fberst/RPI4Soar/README.md

# RPI4Soar

RPI4Soar is a gliding computer based on the Raspbery Pi4B running XCsoar (https://www.xcsoar.org/)

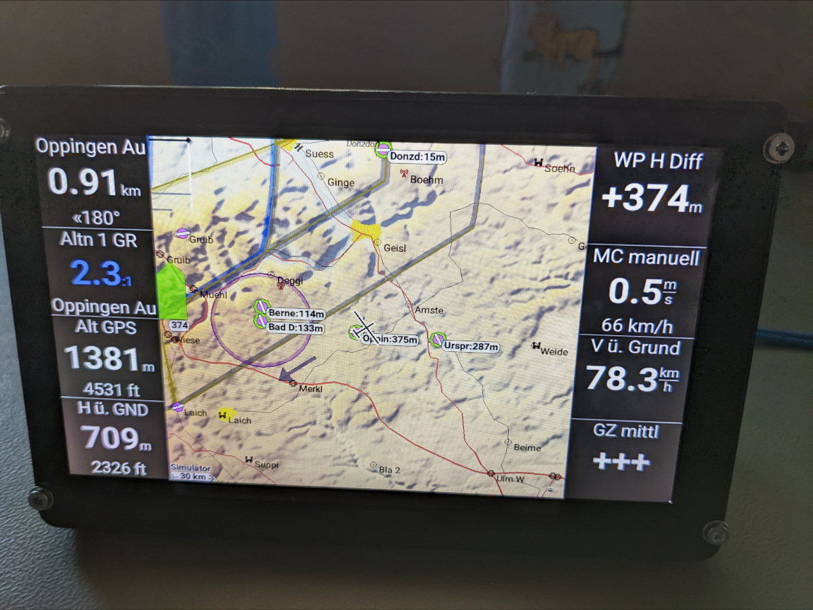
[picture p1: pictures/RPI4Soar.jpg]
RPI4Soar
