fberst/RPI4Soar/pictures/USB_RS232_Adapter_V1_4.jpg

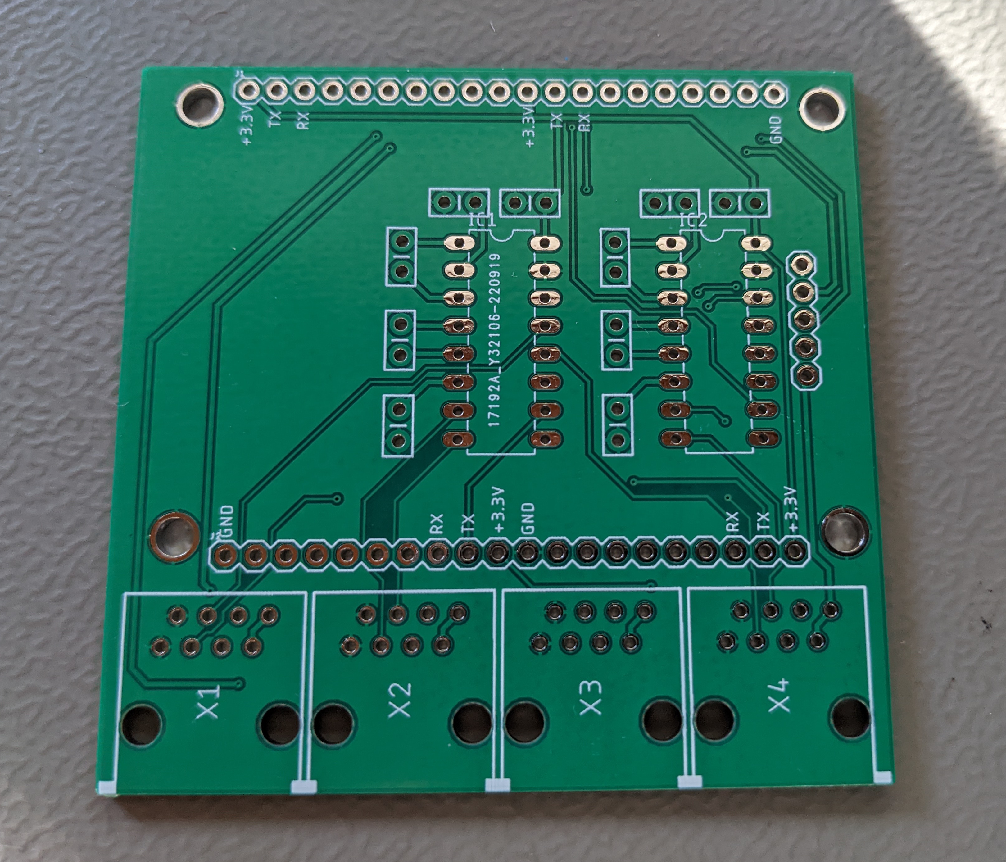
pictures/USB_RS232_Adapter_V1_4.jpg
