fberst/RPI4Soar/documentation/BOM_USB_RS232_V2.ods

Sheet: Parts PCB
# | Part ID | Manufacturer | Part-number | Description | Value | Package | Number of Pins | Source | Price | Quantity | sum
Electronic Parts
1 | IC1, IC2 | Maxim Integrated | MAX 3232 CSE | RS232 level shifter |  | SO-16 | 16 | MAX 3232 CSE | 2,10 € | 2 | 4,20 €
2 | C1, C2, C3, C4, C5, C6, C7, C8, C9, C10 | Samsung Electro-Mechanics | CL21B104KBCNNNC | Capacitor | 100nF | 805 | 2 | 1276-1003-1-ND | 0,07 € | 10 | 0,70 €
3 | X1, X2, X3, X4 | TE Connectivity | 5555162-1 | RJ45-Jacket |  | custom | 8 | 571-5555162-1 | 1,27 € | 4 | 5,08 €
4 | J1, J2 |  | 9900000736774 | socket strip |  | 1x20 2,54mm | 20 | BL 1X20G7 2,54 | 1,06 € | 2 | 2,12 €
5 | FT4232 USB-TTL Converter | Alixpress |  |  |  |  |  |  | 10,69 € | 1 | 10,69 € | https://de.aliexpress.com/item/1005001928940997.html?curPageLogUid=mFcxdsNxnEyo
PCB
6 | USB_RS232_Adaper_V2 | Smart-Prototyping |  |  |  |  |  |  | 2,00 € | 1 | 2,00 €
Mechanical Parts
7 | USB_RS232_Adapter_V1-housing.stl | hubs.com |  |  |  |  |  |  | 11,67 € | 1 | 11,67 €
8 | USB_RS232_Adapter_V1-cap.stl | hubs.com |  |  |  |  |  |  | 9,23 € | 1 | 9,23 €
9 | hexagonal spacer bolt M3, Inner/inner, 8mm length | buerklin | 20080312 |  |  |  |  | 20080312 | 0,19 € | 4 | 0,74 €
10 | hexagonal spacer bolt M3, Inner/outer, 10mm bolt length, 16mm overall length | buerklin | 971100321 |  |  |  |  | 971100321 | 0,32 € | 4 | 1,28 €
11 | Torx screw M3x6mm, countersunk head | screwsandmore | 965236TX_558 |  |  |  |  | 965236TX_558 | 3,99 | 1 | 3,99 € | (4 necessary, but sold in 50-pack)
12 | Torx screw M3x14mm, countersunk head | screwsandmore | 9652314TX_4170 |  |  |  |  | 9652314TX_4170 | 4,69 | 1 | 4,69 € | (4 necessary, but sold in 50-pack)
 |  |  |  |  |  |  |  |  |  |  | 56,39 €

Sheet: Mechanical Parts
# | Description | Part number | Source | Price | Quantity | Sum
1 | Countersunk screw M3x14 | 9652314TX_4170 | screwsandmore | 0,10 € | 4 | 0,40 €
2 | Countersunk screw M3x6 | 965236TX_558 | screwsandmore | 0,08 € | 4 | 0,32 €
3 | standoff M3x10 inner / outer | H1202 ST ZN M3X10 | buerklin | 0,30 € | 4 | 1,20 €
4 | standoff M3x8 inner / outer | 18H2456 | buerklin | 0,20 € | 4 | 0,80 €
5 | housing |  | 3d printed |  | 1
6 | cap |  | 3d printed |  | 1
7 | FT4232 |  | aliexpress.com | 12,54 € | 1 | 12,54 €
 |  |  |  |  |  | 15,26 €
 | FT4232 link:
 | https://www.aliexpress.com/item/1005001928940997.html
