fberst/RPI4Soar/documentation/BOM_RPI4Soar_V2.ods

Sheet: mechanical
# | Description | Part number | Source | Price | Quantity | Sum
1 | mounting block | Typ 05.60.425 | buerklin | 0.89 € | 8 | 7.12 €
2 | M2,5x6 lens hat screw |  | screwsandmore |  | 8
3 | M2,5x10 lens hat screw |  | screwsandmore |  | 4
4 | M2,5x8 countersunk screw |  | screwsandmore |  | 8
5 | M1,6x6 countersunk screw |  | screwsandmore |  | 6
6 | M1,6 nut |  | screwsandmore |  | 6
7 | standoff bolt M2,5x10 inner/outer thread |  | buerklin |  | 4
8 | M2,5 nut |  | screwsandmore |  | 4
9 | M3x30 screw |  | screwsandmore |  | 4
10 | M3 nut |  | screwsandmore |  | 4
11 | RPI4Soar_V2-frame |  | 3d-printed |  | 1
12 | RPI4Soar_V2-housing |  | 3d-printed |  | 1
13 | RPI4Soar_V2-backplate |  | 3d-printed or lasercut |  | 1
14 | RPI4Soar_V2-spacer |  | 3d-printed |  | 4

Sheet: electrical
# | Description | Part number | Source | Price | Quantity | Sum
1 | Raspberry Pi4B |  |  |  | 1
2 | micro-sd card |  |  |  | 1
3 | HA-070XIEB0GH6-A-DGW Display |  | texim | 86.16 € | 1 | 86.16 € | https://www.texim-europe.com/product/HA-070XIEB0GH6-A-DGW
4 | Micro-hdmi type d male connector 90 degree Angled to flat ribbon cable |  | amazon | 7.99 € | 1 | 7.99 € | https://www.amazon.de/gp/product/B01M0AO3J3/ref=ppx_yo_dt_b_asin_title_o00_s00?ie=UTF8&psc=1
5 | hdmi connector 90 degree angled to ribbon cable |  | amazon | 9.35 € | 1 | 9.35 € | https://www.amazon.de/gp/product/B07R6CWPH1/ref=ppx_yo_dt_b_asin_title_o00_s00?ie=UTF8&psc=1
6 | ribbon cable |  | amazon |  | 1
7 | mpx power connector |  | hoelleinshop | 1.50 € | 1 | 1.50 € | https://www.hoelleinshop.com/mpx-hochstromstecker-M6-50.htm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
8 | mpx power connector mounting frame |  | hoelleinshop | 0.90 € | 1 | 0.90 € | https://www.hoelleinshop.com/Alles-fuer-den-Elektroflug/Elektroflug-Zubehoer/Steckersysteme/sonstige-Stecker/Einbaurahmen-lang-zu-MPX-Hochstromstecker-Buchse.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
9 | power supply pcb (see eagle files) |  |  |  | 1
10

Sheet: pcb_parts
# | Part ID | Manufacturer | Part-number | Description | Value | Package | Number of Pins | Source | Price | Quantity
1 | J1 | W+P | W+P 153PF-040-2 | Raspberry Pi4B pin-socket | --- | THT 2,54mm 2x20 | 40 | W+P 153PF-040-2 | 6.40 € | 1
2 | U$1 | Traco Power | THN 15-2411WI-A1 | 5V voltage regulator | 5V | custom | 6 | 495-THN15-2411WI-A1 | 40.06 € | 1
3 | U$2 | Traco Power | THN 15-2412WI | 12V voltage regulator | 12V | custom | 6 | 495-THN-15-2412WI | 38.10 € | 1
4 | D1 | LSCE | 1N 4004 | diode | --- | DO41-10 | 2 | 1N 4004 | 0.05 € | 1
5 | F1 | Littelfuse | LITT RUEF185 | fuse | --- | custom | 2 | LITT RUEF185 | 0.37 € | 1
optional features, not used at the moment, untested
the connectors can be left out and wires soldered direct to the pads
6 | J2 | Garry | MPE 087-2-006 | fan connector | --- | 2x3, 2,54mm | 6 | MPE 087-2-006 | 0.16 € | 1
7 | J3 | Garry | MPE 087-1-004 | RS232 connector | --- | 1x4, 2,54mm | 4 | MPE 087-1-004 | 0.11 € | 1
8 | J4 | JST | JST XH3P ST90 | backlight dimming connector | --- | 1x3, 2,54mm | 3 | JST XH3P ST90 | 0.24 € | 1
9 | J6 | JST | JST XH2P ST90 | backlight power connector |  | 1x2, 2,54mm | 2 | JST XH2P ST90 | 0.20 € | 1
10 | J7 | JST | JST XH2P ST90 | power connector |  | 1x2, 2,54mm | 2 | JST XH2P ST90 | 0.20 € | 1
11 | IC1 | Maxim | MAX 3232 CPE | RS232 level shifter | MAX 3232 CPE | PDIP-16 | 16 | MAX 3232 CPE | 8.23 € | 1
12 | C1, C2, C3, C4, C5 | Vishay / BC Components | K104K15X7RF5UL2 | capacitor | 100nF | THT 2,54mm | 2 | 594-K104K15X7RF5UL2 | 0.23 € | 5
