fberst/RPI4Soar/CAD/RPI4Soar_V2.FCStd

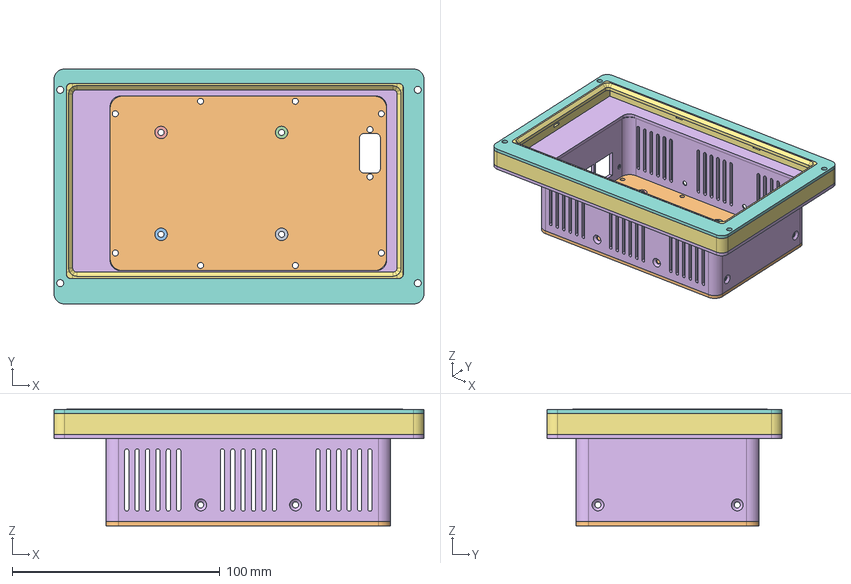
[picture p6: CAD file, 2023-02-26]
CAD/RPI4Soar_V2.FCStd
178.0 x 113.0 x 56.1 mm
Spacer
Backplate
Spacer1
Spacer2
Spacer3
housing
frame
template
