fberst/RPI4Soar/CAD/RPI4Soar_V2-template.stl

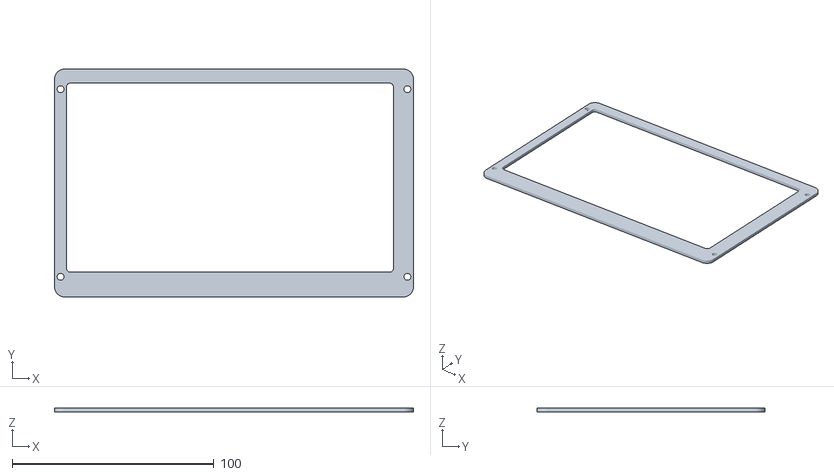
[picture p7: CAD file, 2023-02-26]
CAD/RPI4Soar_V2-template.stl
178.0 x 113.0 x 2.00
