fberst/RPI4Soar/CAD/RPI4Soar_V2-housing.stl

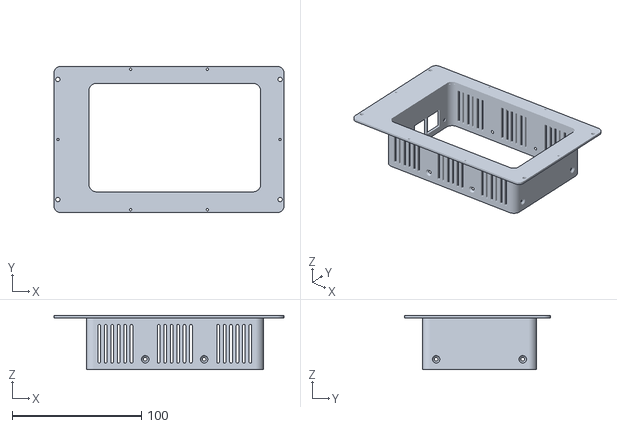
[picture p8: CAD file, 2023-02-25]
CAD/RPI4Soar_V2-housing.stl
178.0 x 113.0 x 42.0
