fberst/RPI4Soar/CAD/RPI4Soar_V2-Spacer.stl

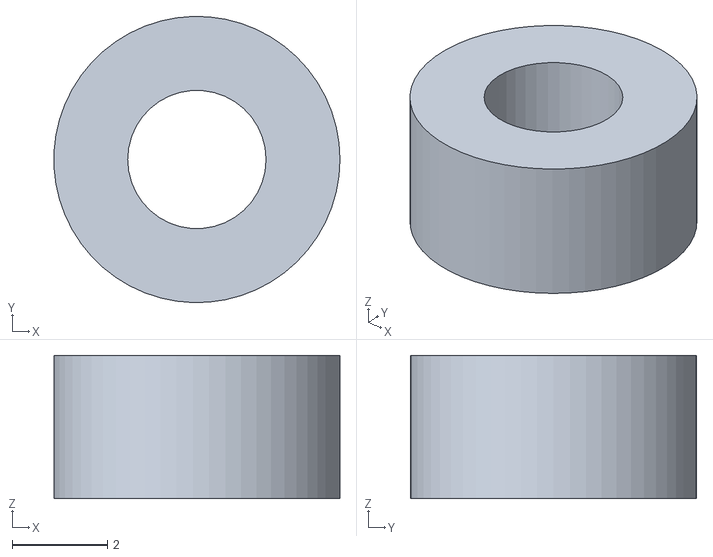
[picture p9: CAD file, 2023-02-25]
CAD/RPI4Soar_V2-Spacer.stl
6.00 x 6.00 x 3.00
