fberst/RPI4Soar/CAD/RPI4Soar_V2-frame.stl

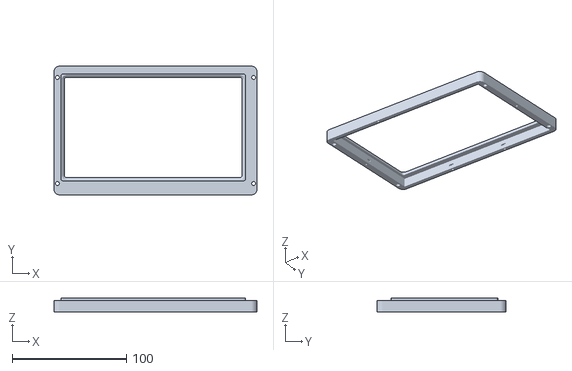
[picture p10: CAD file, 2023-02-25]
CAD/RPI4Soar_V2-frame.stl
178.0 x 113.0 x 12.1
