fberst/RPI4Soar/CAD/USB_RS232_Adapter_V1-housing.stl

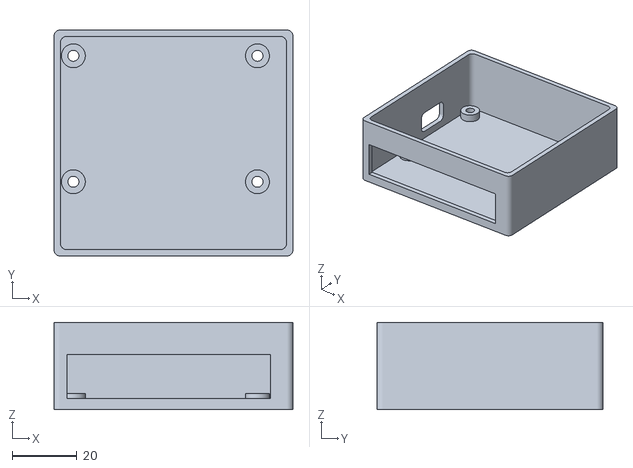
[picture p12: CAD file, 2023-02-23]
CAD/USB_RS232_Adapter_V1-housing.stl
74.0 x 70.0 x 27.0
