fberst/RPI4Soar/CAD/USB_RS232_Adapter_V1.FCStd

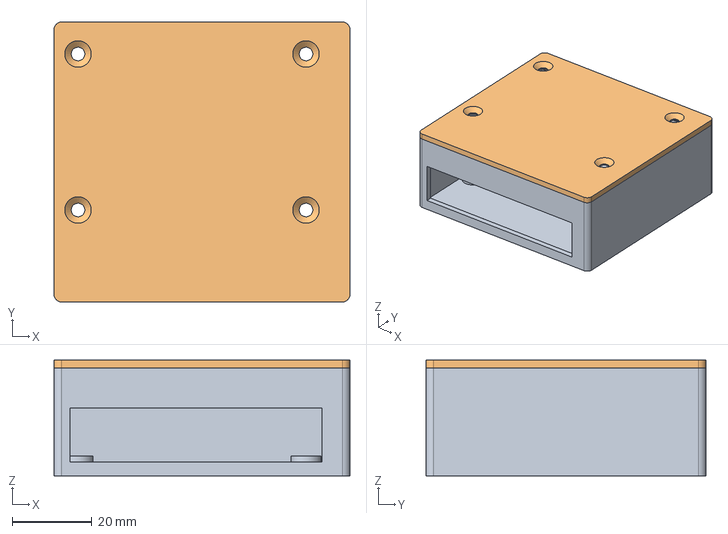
[picture p13: CAD file, 2023-02-23]
CAD/USB_RS232_Adapter_V1.FCStd
74.0 x 70.0 x 29.0 mm
housing
cap
