fberst/RPI4Soar/CAD/RPI4Soar_V2-Backplate.stl

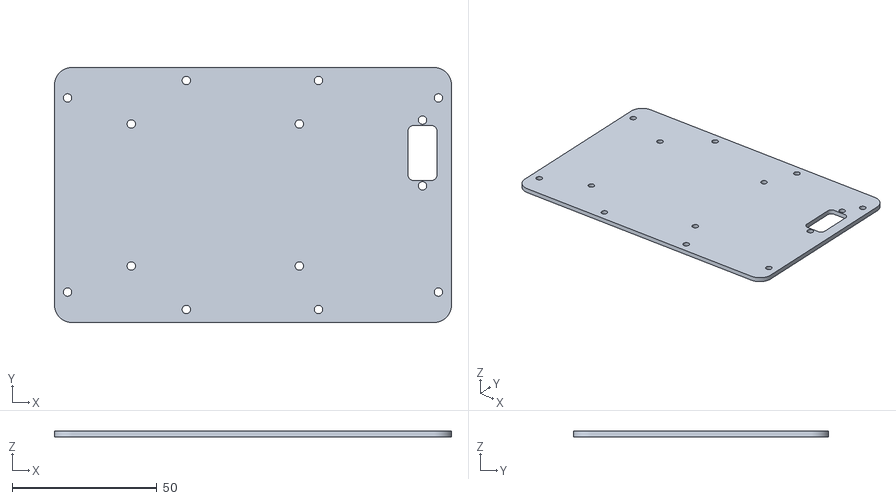
[picture p14: CAD file, 2023-02-23]
CAD/RPI4Soar_V2-Backplate.stl
137.0 x 88.0 x 2.00
