fberst/RPI4Soar/CAD/RPI4Soar_V1-Frame.stl

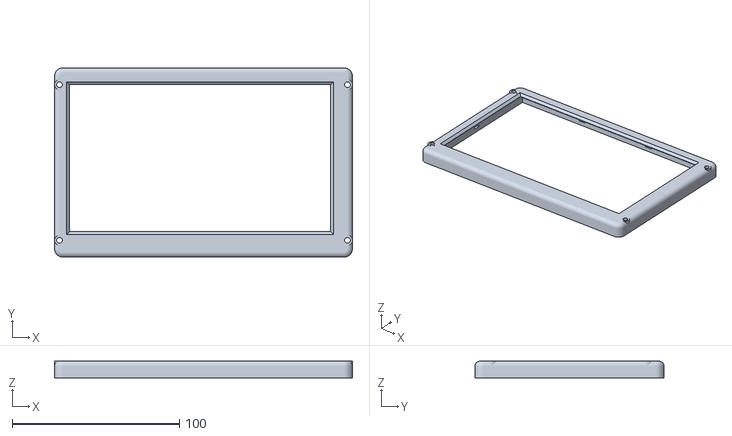
[picture p15: CAD file, 2023-02-23, an earlier design]
CAD/RPI4Soar_V1-Frame.stl
178.0 x 113.0 x 10.1
