fberst/RPI4Soar/CAD/RPI4Soar_V1-Spacer.stl

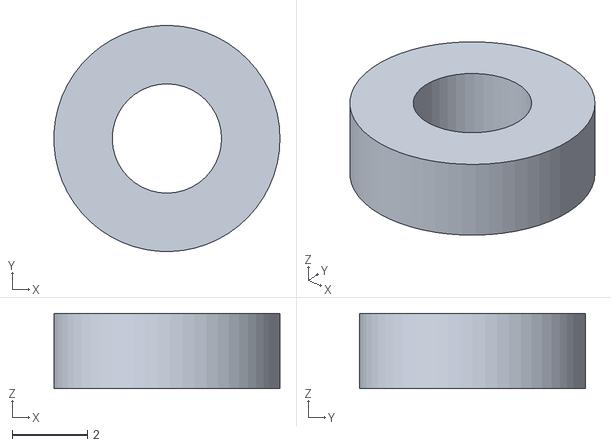
[picture p16: CAD file, 2023-02-23, an earlier design]
CAD/RPI4Soar_V1-Spacer.stl
6.00 x 6.00 x 2.00
