fberst/RPI4Soar/CAD/RPI4Soar_V1-Housing.stl

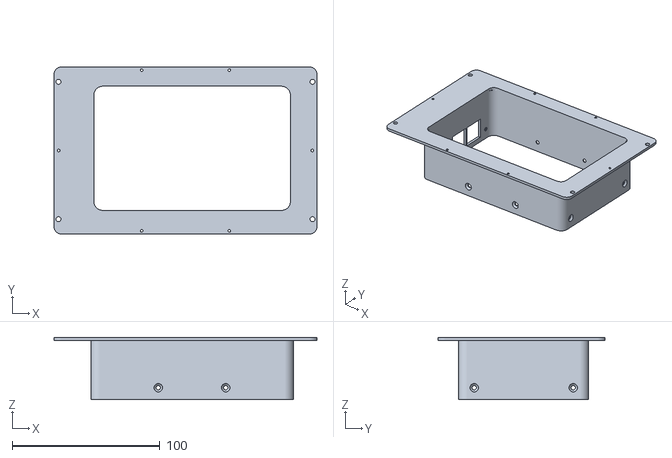
[picture p17: CAD file, 2023-02-23, an earlier design]
CAD/RPI4Soar_V1-Housing.stl
178.0 x 113.0 x 42.0
