fberst/RPI4Soar/CAD/RPI4Soar_V1.FCStd

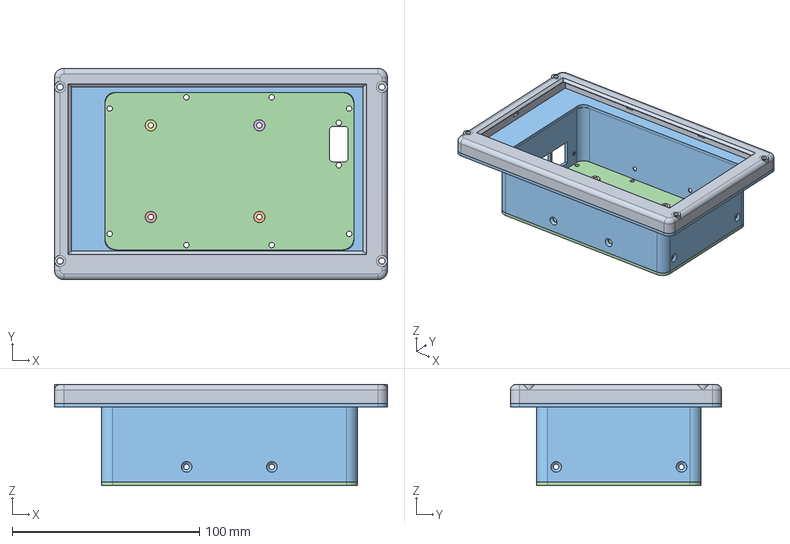
[picture p18: CAD file, 2023-02-23, an earlier design]
CAD/RPI4Soar_V1.FCStd
178.0 x 113.0 x 54.1 mm
Frame
Spacer
Housing
Backplate
Spacer1
Spacer2
Spacer3
