fberst/RPI4Soar/(threads)

Thread 1 (2025-04-26):

Question: How did you arange the electric components inside the RPI4Soar housing?

lordfolken, 2025-04-26:
I built it from your prints, but i have a hardtime with the hdmi board for the display. Its about as big as the opening and both hdmi and 12v power plug stick out from it.
