fberst/RPI4Soar/electronics/RPI4Soar_V1.brd

## EAGLE design electronics/RPI4Soar_V1.brd (2023-02-26)

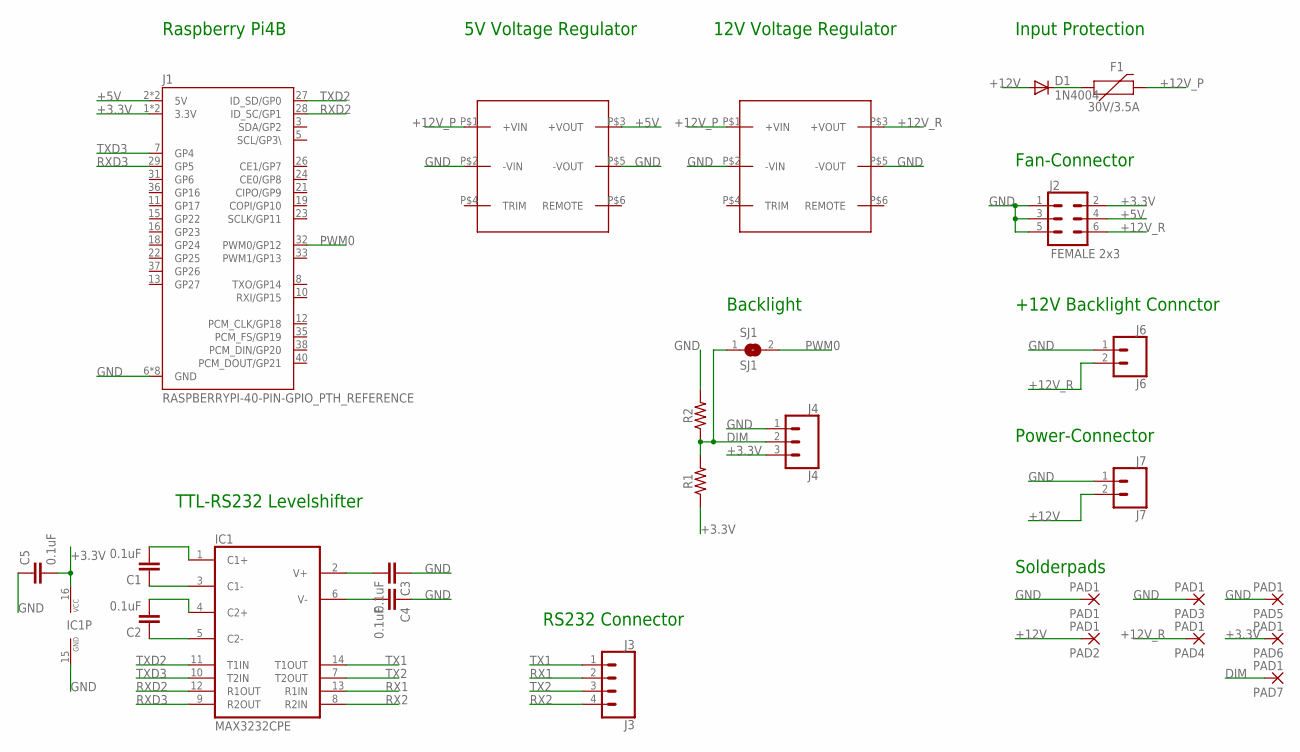
[picture p19: schematic RPI4Soar_V1.sch]

Parts:
C1, C2, C3, C4, C5: 0.1uF; CAP-PTH-SMALL-KIT
D1: 1N4004; DO41-10
F1: 30V/3.5A; PTH
IC1: MAX3232CPE; DIL16
J1: RASPBERRYPI-40-PIN-GPIO_PTH_REFERENCE; RASPBERRY_PI_HAT_40_PIN_PTH_WITH_REFERNCE
J2: FEMALE 2x3; 2X3
J3: J3; 1X04
J4: J4; 1X03
J6: J6; 1X02
J7: J7; 1X02
PAD1, PAD2, PAD3, PAD4, PAD5, PAD6, PAD7: PAD1; SMD2,54-5,08
R1, R2: AXIAL-0.3
SJ1: SJ1; SJ
U$1: TRACO_THN15WI +5V; TRACO_THN15WI
U$2: TRACO_THN15WI +12V; TRACO_THN15WI

Connections:
+3.3V: C5.2, IC1.16 (VCC), J1.1 (3.3V), J1.17 (3.3V), J2.2, J4.3, PAD6.1, R1.P$1 (1)
+5V: J1.2 (5V), J1.4 (5V), J2.4, U$1.P$3 (+VOUT)
+12V: D1.A, J7.2, PAD2.1
+12V_P: F1.P$2 (2), U$1.P$1 (+VIN), U$2.P$1 (+VIN)
+12V_R: J2.6, J6.2, PAD4.1, U$2.P$3 (+VOUT)
DIM: J4.2, PAD7.1, R1.P$2 (2), R2.P$1 (1), SJ1.1
GND: C3.1, C4.1, C5.1, IC1.15 (GND), J1.6 (GND), J1.9 (GND), J1.14 (GND), J1.20 (GND), J1.25 (GND), J1.30 (GND), J1.34 (GND), J1.39 (GND), J2.1, J2.3, J2.5, J4.1, J6.1, J7.1, PAD1.1, PAD3.1, PAD5.1, R2.P$2 (2), U$1.P$2 (-VIN), U$1.P$5 (-VOUT), U$2.P$2 (-VIN), U$2.P$5 (-VOUT)
unnamed: D1.C, F1.P$1 (1)
unnamed: C2.1, IC1.5 (C2-)
unnamed: C2.2, IC1.4 (C2+)
unnamed: C1.1, IC1.3 (C1-)
unnamed: C1.2, IC1.1 (C1+)
unnamed: C3.2, IC1.2 (V+)
unnamed: C4.2, IC1.6 (V-)
PWM0: J1.32 (PWM0/GP12), SJ1.2
RX1: IC1.13 (R1IN), J3.2
RX2: IC1.8 (R2IN), J3.4
RXD2: IC1.12 (R1OUT), J1.28 (ID_SC/GP1)
RXD3: IC1.9 (R2OUT), J1.29 (GP5)
TX1: IC1.14 (T1OUT), J3.1
TX2: IC1.7 (T2OUT), J3.3
TXD2: IC1.11 (T1IN), J1.27 (ID_SD/GP0)
TXD3: IC1.10 (T2IN), J1.7 (GP4)

Notes on the sheet:
Raspberry Pi4B
5V Voltage Regulator
12V Voltage Regulator
Input Protection
Fan-Connector
+12V Backlight Connctor
Power-Connector
Backlight
TTL-RS232 Levelshifter
RS232 Connector
Solderpads

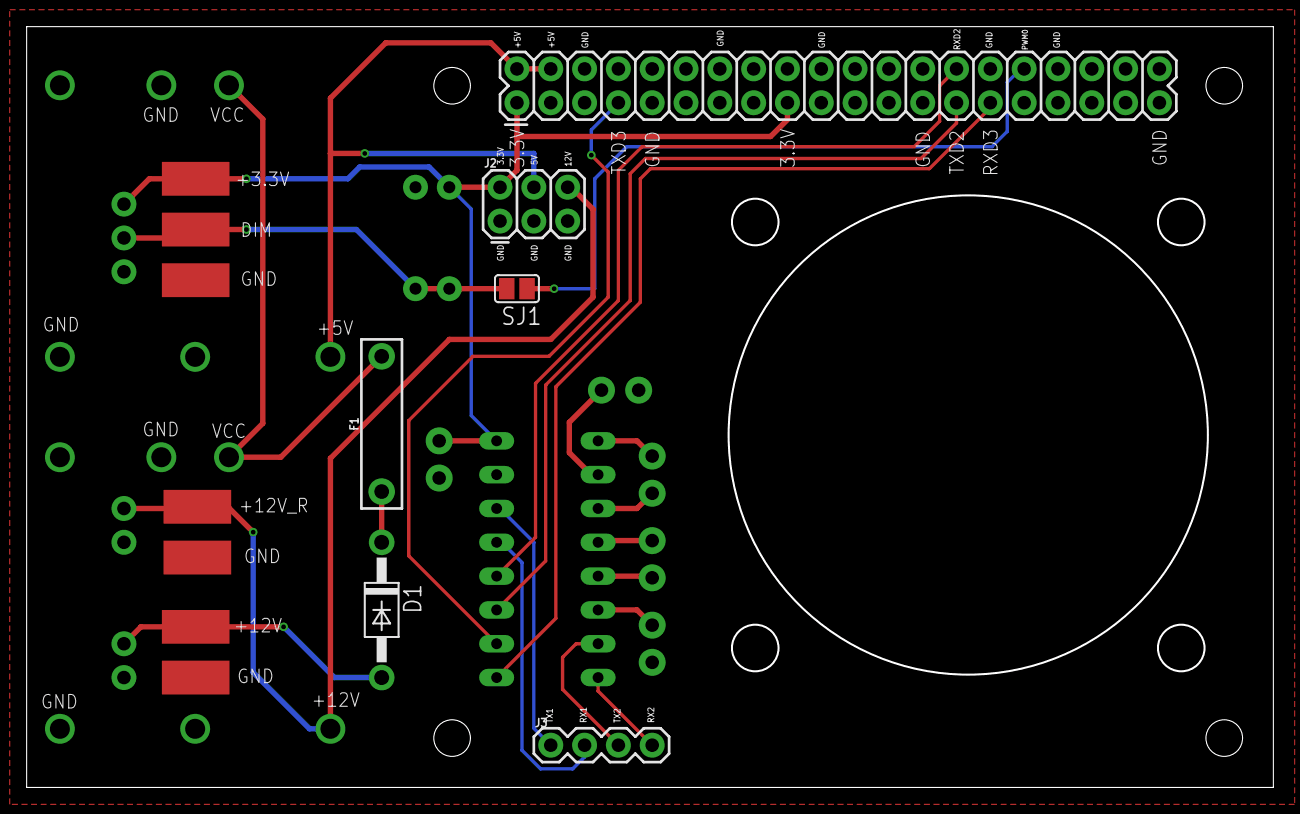
[picture p20: board RPI4Soar_V1.brd from above]

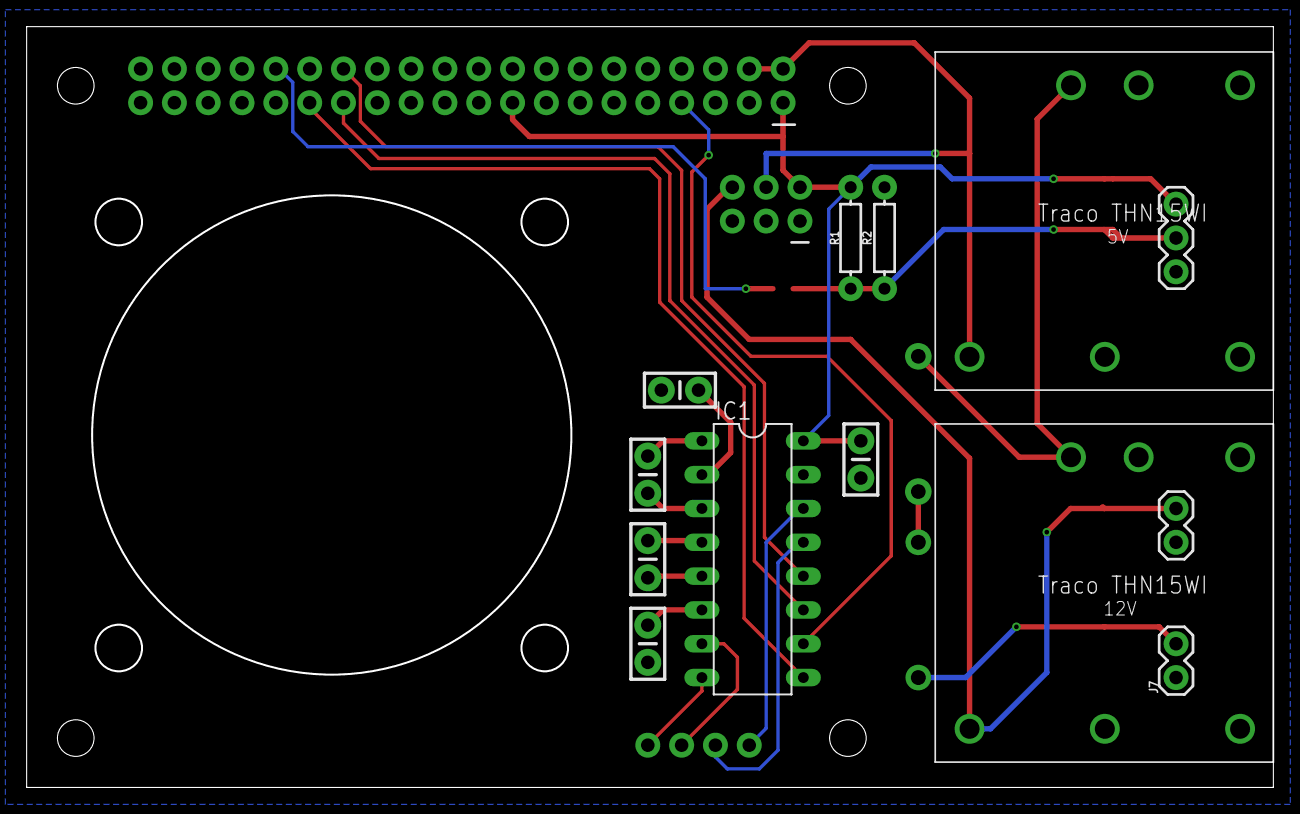
[picture p21: board RPI4Soar_V1.brd from below]

Board: 2 copper layers, 93.7 x 57.1 mm, 26 parts (13 on the bottom side), 23 nets.
