fberst/RPI4Soar/electronics/USB_RS232_Adaper_V2.brd

## EAGLE design electronics/USB_RS232_Adaper_V2.brd (2023-02-26)

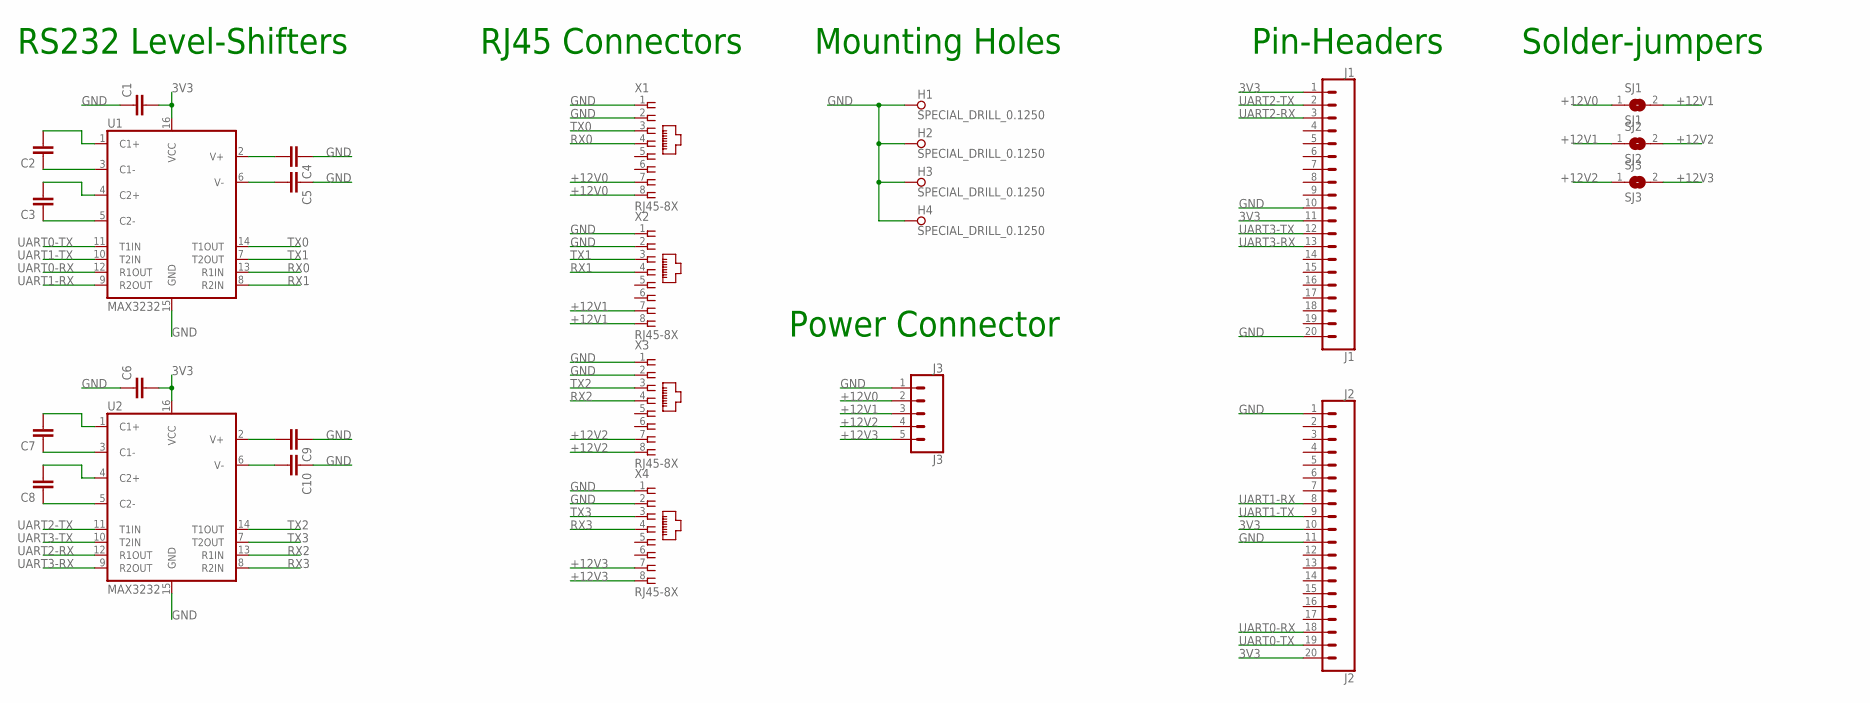
[picture p22: schematic USB_RS232_Adaper_V2.sch]

Parts:
C1, C2, C3, C4, C5, C6, C7, C8, C9, C10: 0.1uF; 0805
H1, H2, H3, H4: SPECIAL_DRILL_0.1250; PAD_0.1250
J1: J1; 1X20
J2: J2; 1X20
J3: J3; 1X05
SJ1: SJ1; SJ
SJ2: SJ2; SJ
SJ3: SJ3; SJ
U1, U2: MAX3232; SO16
X1, X2, X3, X4: RJ45-8X; RJ45-NO-SHIELD

Connections:
3V3: C1.2, C6.2, J1.1, J1.11, J2.10, J2.20, U1.16 (VCC), U2.16 (VCC)
+12V0: J3.2, SJ1.1, X1.7, X1.8
+12V1: J3.3, SJ1.2, SJ2.1, X2.7, X2.8
+12V2: J3.4, SJ2.2, SJ3.1, X3.7, X3.8
+12V3: J3.5, SJ3.2, X4.7, X4.8
GND: C1.1, C4.1, C5.1, C6.1, C9.1, C10.1, H1.1, H2.1, H3.1, H4.1, J1.10, J1.20, J2.1, J2.11, J3.1, U1.15 (GND), U2.15 (GND), X1.1, X1.2, X2.1, X2.2, X3.1, X3.2, X4.1, X4.2
unnamed: C2.1, U1.3 (C1-)
unnamed: C2.2, U1.1 (C1+)
unnamed: C3.1, U1.5 (C2-)
unnamed: C3.2, U1.4 (C2+)
unnamed: C4.2, U1.2 (V+)
unnamed: C5.2, U1.6 (V-)
unnamed: C9.2, U2.2 (V+)
unnamed: C10.2, U2.6 (V-)
unnamed: C7.1, U2.3 (C1-)
unnamed: C8.1, U2.5 (C2-)
unnamed: C8.2, U2.4 (C2+)
unnamed: C7.2, U2.1 (C1+)
RX0: U1.13 (R1IN), X1.4
RX1: U1.8 (R2IN), X2.4
RX2: U2.13 (R1IN), X3.4
RX3: U2.8 (R2IN), X4.4
TX0: U1.14 (T1OUT), X1.3
TX1: U1.7 (T2OUT), X2.3
TX2: U2.14 (T1OUT), X3.3
TX3: U2.7 (T2OUT), X4.3
UART0-RX: J2.18, U1.12 (R1OUT)
UART0-TX: J2.19, U1.11 (T1IN)
UART1-RX: J2.8, U1.9 (R2OUT)
UART1-TX: J2.9, U1.10 (T2IN)
UART2-RX: J1.3, U2.12 (R1OUT)
UART2-TX: J1.2, U2.11 (T1IN)
UART3-RX: J1.13, U2.9 (R2OUT)
UART3-TX: J1.12, U2.10 (T2IN)

Notes on the sheet:
RS232 Level-Shifters
RJ45 Connectors
Mounting Holes
Power Connector
Pin-Headers
Solder-jumpers

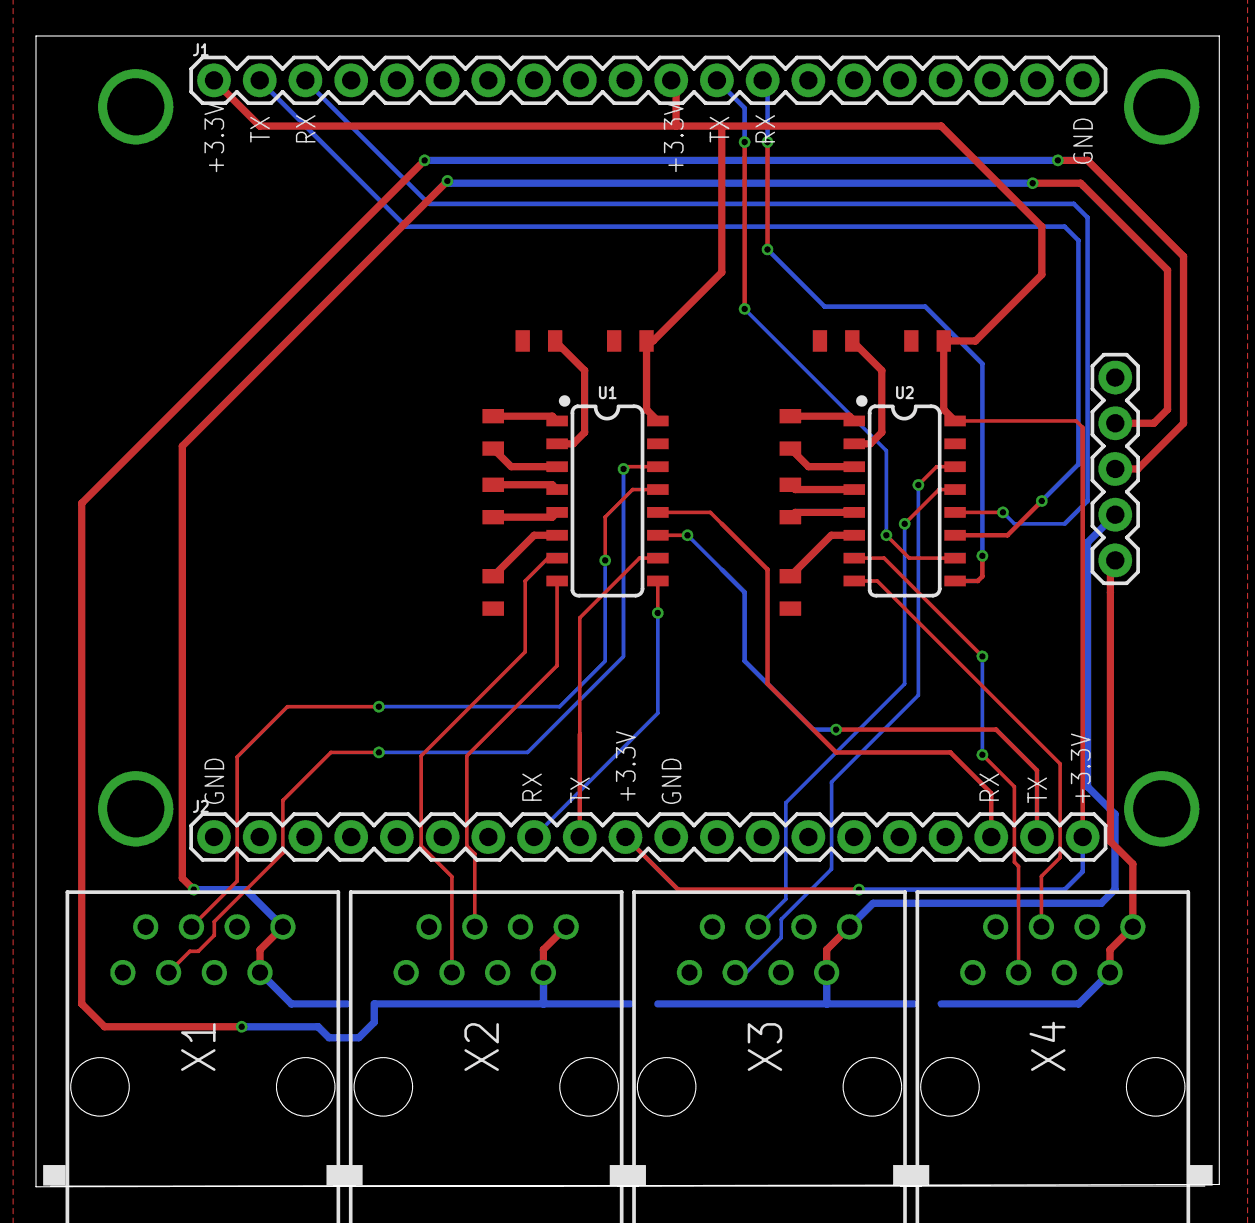
[picture p23: board USB_RS232_Adaper_V2.brd from above]

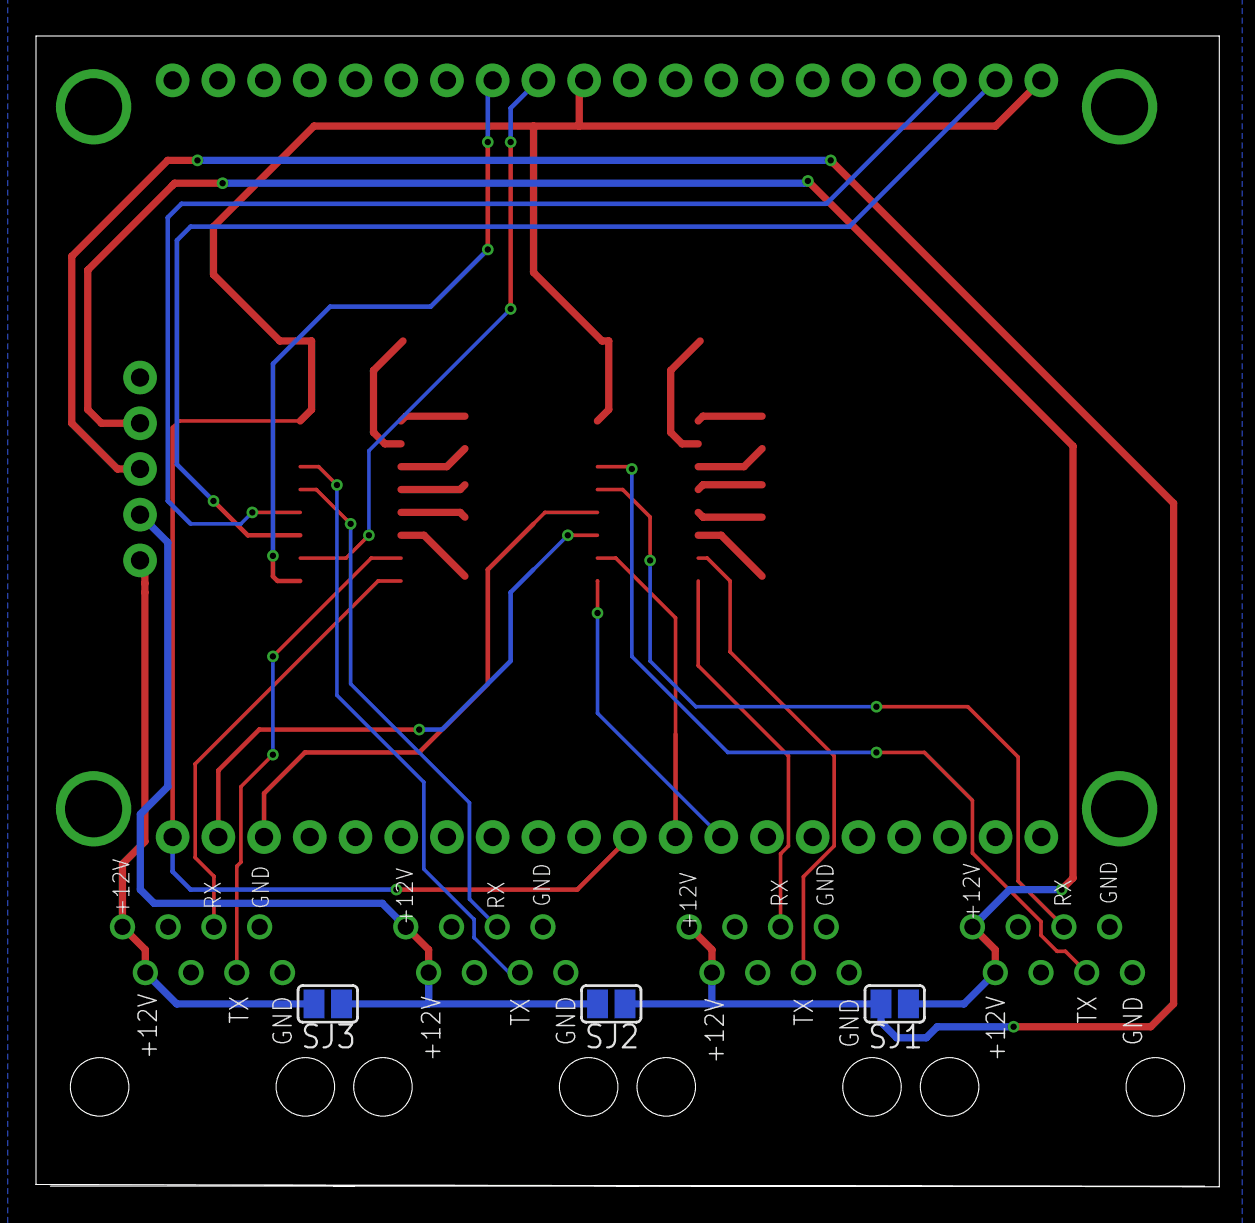
[picture p24: board USB_RS232_Adaper_V2.brd from below]

Board: 2 copper layers, 65.7 x 63.9 mm, 26 parts (3 on the bottom side), 34 nets.
