fberst/RPI4Soar/(commit log)

2023-02-23 add RPI4Soar_V1 CAD files
    [RPI4Soar_V1-Backplate.stl, RPI4Soar_V1-Frame.stl, RPI4Soar_V1-Housing.stl, RPI4Soar_V1-Spacer.stl, RPI4Soar_V1.FCStd]
2023-02-23 add USB_RS232_Adapter CAD files
    [USB_RS232_Adapter_V1-cap.stl, USB_RS232_Adapter_V1-housing.stl, USB_RS232_Adapter_V1.FCStd]
2023-02-23 add RPI4Soar power supply pcb
    [RPI4Soar_V1.brd, RPI4Soar_V1.sch]
2023-02-23 add USB_RS232_Adapter_V1 pcb
    [USB_RS232_Adaper_V1.brd, USB_RS232_Adaper_V1.sch]
2023-02-23 add BOM_USB_RS232_Adapter
    [BOM_USB_RS232_V1.ods]
2023-02-25 CAD: add RPISoar_V2
    [RPI4Soar_V2-Backplate.stl, RPI4Soar_V2-Spacer.stl, RPI4Soar_V2-frame.stl, RPI4Soar_V2-housing.stl, RPI4Soar_V2.FCStd]
2023-02-26 CAD: add template for panel cutout
    [RPI4Soar_V2-template.stl, RPI4Soar_V2.FCStd]
2023-02-26 added USB_RS232_Adapter_V2
    [BOM_USB_RS232_V2.ods, USB_RS232_Adaper_V2.brd, USB_RS232_Adaper_V2.sch]
2023-02-26 add RPI4Soar BOM
    [BOM_RPI4Soar_V2.ods, RPI4Soar_V1.brd, RPI4Soar_V1.sch]
2025-08-31 BOM_USB_RS232_V1.ods: add missing parts
    [BOM_USB_RS232_V1.ods]
2025-08-31 BOM_USB_RS232_V2.ods: add missing parts
    [BOM_USB_RS232_V2.ods]
